kubedzero/arduino-projects/board pinouts.png

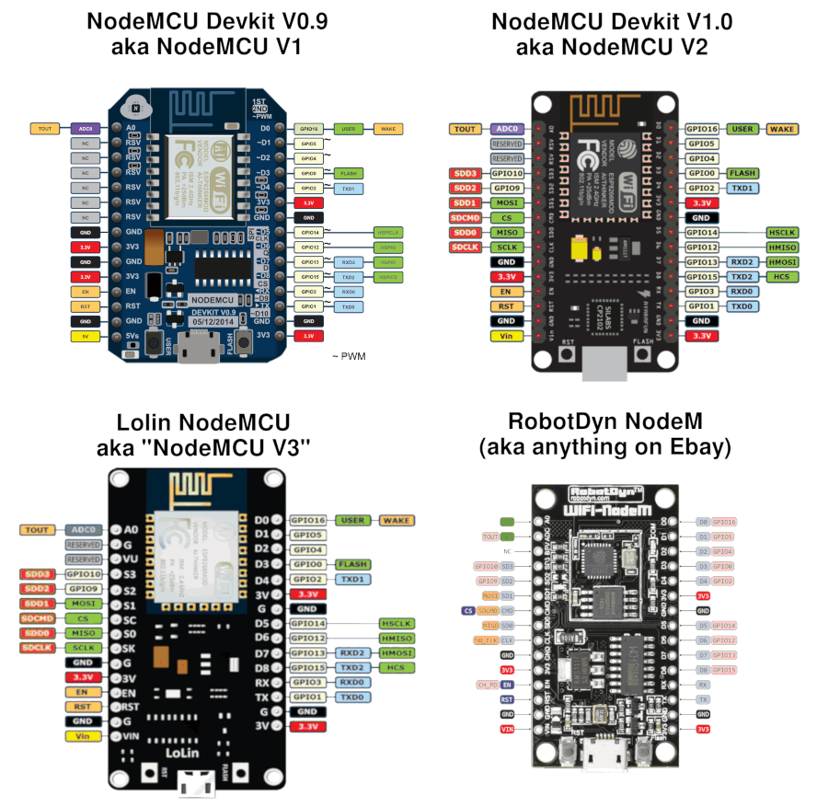
board pinouts.png
