kubedzero/arduino-projects/toggleHttpSwitch/Schematic_Tasmota Switch_2020-10-20_21-03-20.png

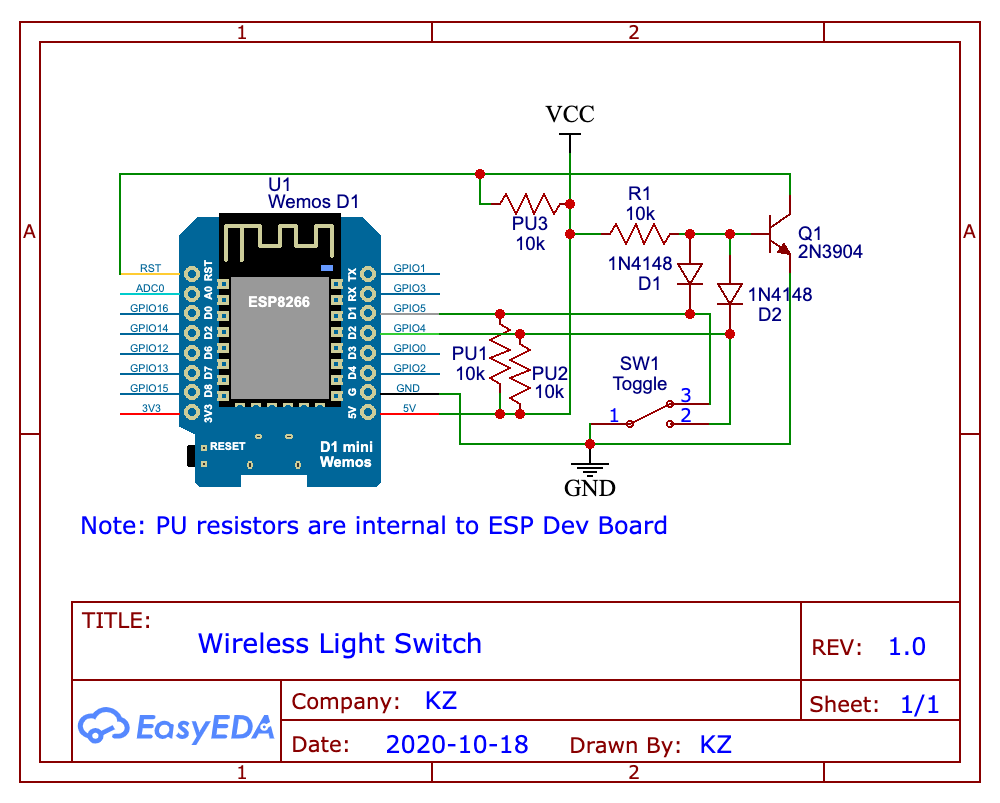
toggleHttpSwitch/Schematic_Tasmota Switch_2020-10-20_21-03-20.png
