kubedzero/arduino-projects/(list of files, drawings)

Other design files:
toggleHttpSwitch/circuitDiagramEasyEDA.json
