kubedzero/arduino-projects/(commit log)

2019-09-28 Initial commit of sensorWebServer, cloned from OTA Update
2019-09-28 working code for swappable BME and BMP
    [sensorWebServer.ino]
2019-09-29 Cleanup of code, add methodized sensor retrieval and printout
2019-09-29 Working PMS7003 sensor reading without additional libraries.
2019-09-29 PMS incorporated into sensor updates and web readout
2019-09-29 Handle our own WiFi reconnect with LED indication
2019-09-29 Fix PMS data retrieval method to more reliably update results
    [sensorWebServer.ino]
2019-10-01 Updated sensor sketch to use PMS library after checksum errors with my own.
    [sensorWebServer.ino]
2019-12-21 Add restart page to reboot the ESP
    [sensorWebServer.ino]
2020-07-11 Library updates, current versions don't have corrupted logs
2020-07-11 Update libraries to currently used versions. ESP is 2.7.2
2020-10-19 Enable TV powering
2020-10-21 Add circuit diagram
    [circuitDiagramEasyEDA.json]
2021-09-25 Switch to Adafruit VEML6075 library. Update other libraries. Standardize comment style.
2021-09-25 Disable TV power toggle, update libraries, fix breaking log change
    [sensorWebServer.ino, toggleHttpSwitch.ino]
2021-10-10 partially refactored code, not done yet. Also ESP32 code
2021-10-16 Finalize ESP8266 copy of the sensorWebServer code
2021-10-16 Copy ESP8266 logic to ESP32, all that remains is OTA
2021-10-16 Enable ESP32 OTA Updates
2022-01-28 Fix 5 second blinking bug, Library updates
    [sensorWebServer.ino, sensorWebServerESP32.ino]
2023-01-07 Add specific board manager details, add reboot URL, optimize PMS reads
    [sensorWebServer.ino, sensorWebServerESP32.ino]
2023-07-21 Reformat, library update, PMS error handling with longer read length
    [sensorWebServerESP32.ino]
2023-10-02 Added SCD40 True CO2 Sensor Support
2023-10-02 Remove ArduinoOTA as it's not used
2023-10-02 Sync error handling between ESP32 and 8266, don't output SCD values when they cannot be read
    [sensorWebServer.ino, sensorWebServerESP32.ino]
2023-10-03 Corrected LED behavior for ESP32 (inverse of ESP8266) and updated README
    Also removed an unused readme.txt, and unified verbiage across ESP8266 and ESP32 versions
    [sensorWebServer.ino, sensorWebServerESP32.ino]
